jnnycn007/Neptune/32X_main1.kicad_sch

## KiCad design 32X_main1.kicad_sch (2026-05-18)

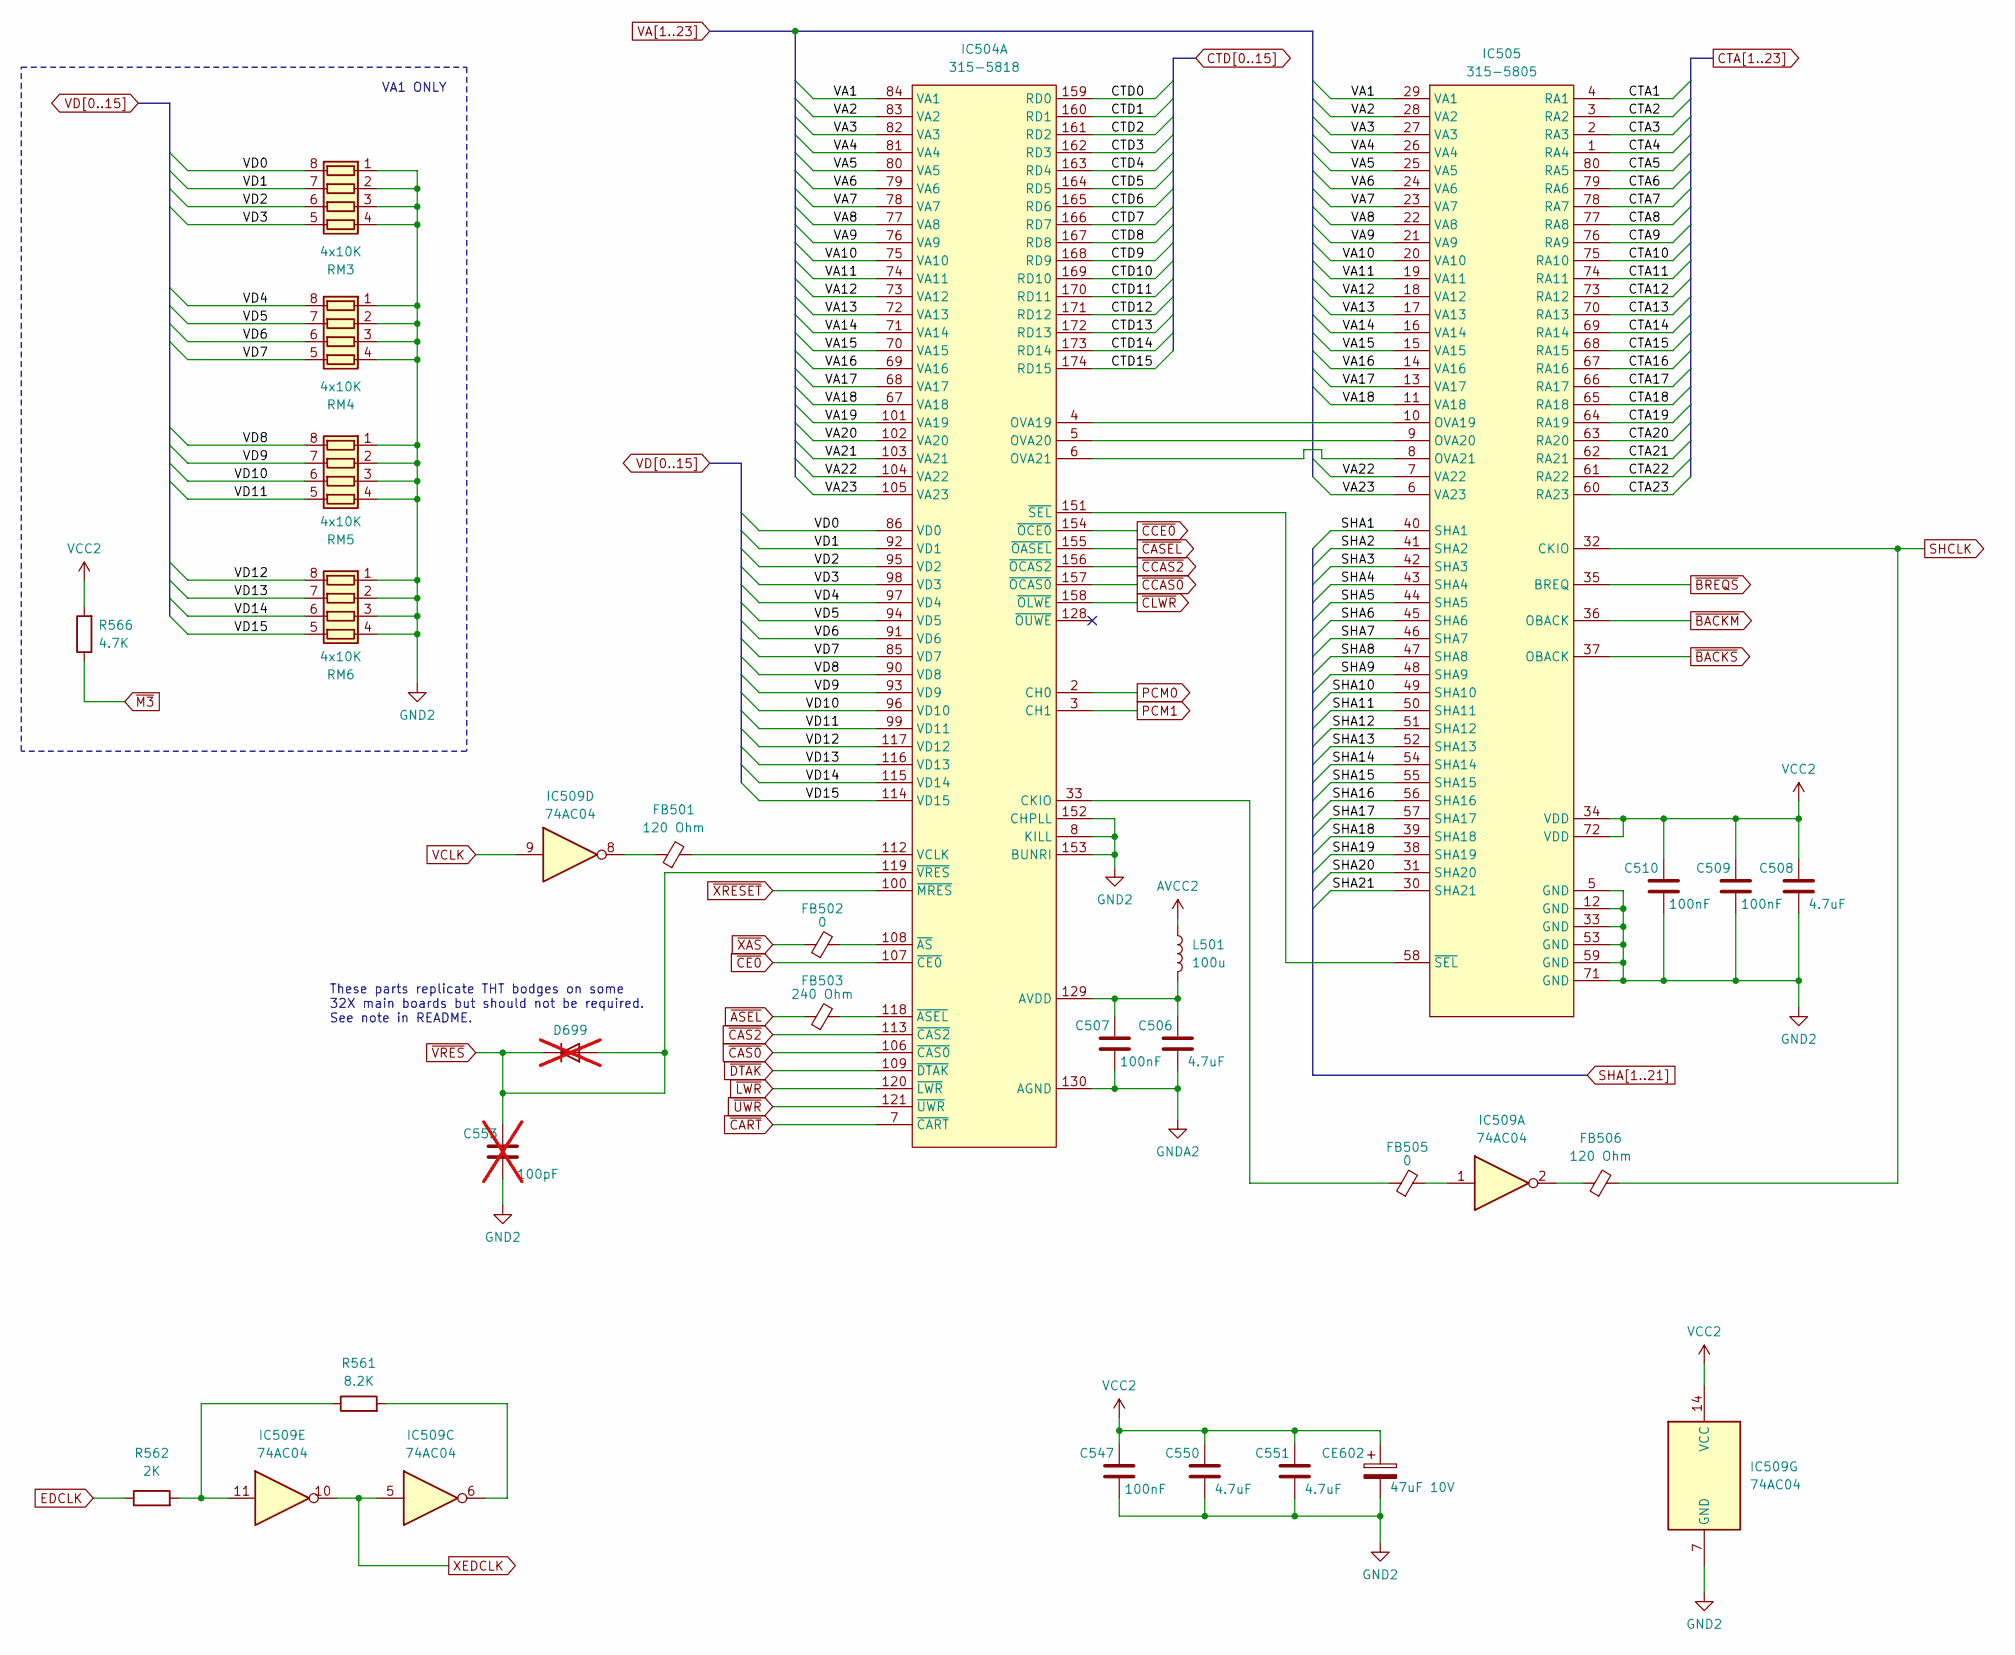
[picture p1: schematic 32X_main1.kicad_sch]

Parts:
C506, C508, C550, C551: 4.7uF; C_1206_3216Metric; MPN VJ1206V475MXJTW1BC; LCSC Part # C132170
C507, C509, C510, C547: 100nF; C_0805_2012Metric; MPN VJ0805Y104JXJMT; LCSC Part # C111492
C553: 100pF; C_0805_2012Metric; not fitted
CE602: 47uF 10V; CP_Radial_D5.0mm_P2.50mm
D699: D_1206_3216Metric; not fitted
FB501, FB506: 120 Ohm; L_0805_2012Metric; MPN CBG201209U121T; LCSC Part # C41330
FB502, FB505: 0; L_0805_2012Metric; MPN CBG201209U000T; LCSC Part # C91037
FB503: 240 Ohm; L_0805_2012Metric; MPN CBG201209U221T; LCSC Part # C124102
IC504: 315-5818; LQFP-176_24x24mm_P0.5mm
IC505: 315-5805; PQFP-80_14x20mm_P0.8mm
IC509: 74AC04; SO-14_Dual_Purpose_P1.27mm; MPN SN74AC04DR; LCSC Part # C352940
L501: 100u; L_1210_3225Metric_Pad1.42x2.65mm_HandSolder; MPN CMI322513J101KT; LCSC Part # C27775
R561: 8.2K; R_0805_2012Metric; MPN CRCW08058K20FKEA; LCSC Part # C844640
R562: 2K; R_0805_2012Metric; MPN CRCW08052K00JNEA; LCSC Part # C2077049
R566: 4.7K; R_0805_2012Metric; MPN CRCW08054K70JNEAC; LCSC Part # C2077067
RM3, RM4, RM5, RM6: 4x10K; R_Array_Convex_4x0603; MPN YC164-FR-0710KL; LCSC Part # C110924

Connections:
AVCC2: L501.1
CTA1: IC505.4 (RA1)
CTA2: IC505.3 (RA2)
CTA3: IC505.2 (RA3)
CTA4: IC505.1 (RA4)
CTA5: IC505.80 (RA5)
CTA6: IC505.79 (RA6)
CTA7: IC505.78 (RA7)
CTA8: IC505.77 (RA8)
CTA9: IC505.76 (RA9)
CTA10: IC505.75 (RA10)
CTA11: IC505.74 (RA11)
CTA12: IC505.73 (RA12)
CTA13: IC505.70 (RA13)
CTA14: IC505.69 (RA14)
CTA15: IC505.68 (RA15)
CTA16: IC505.67 (RA16)
CTA17: IC505.66 (RA17)
CTA18: IC505.65 (RA18)
CTA19: IC505.64 (RA19)
CTA20: IC505.63 (RA20)
CTA21: IC505.62 (RA21)
CTA22: IC505.61 (RA22)
CTA23: IC505.60 (RA23)
CTD0: IC504.159 (RD0)
CTD1: IC504.160 (RD1)
CTD2: IC504.161 (RD2)
CTD3: IC504.162 (RD3)
CTD4: IC504.163 (RD4)
CTD5: IC504.164 (RD5)
CTD6: IC504.165 (RD6)
CTD7: IC504.166 (RD7)
CTD8: IC504.167 (RD8)
CTD9: IC504.168 (RD9)
CTD10: IC504.169 (RD10)
CTD11: IC504.170 (RD11)
CTD12: IC504.171 (RD12)
CTD13: IC504.172 (RD13)
CTD14: IC504.173 (RD14)
CTD15: IC504.174 (RD15)
EDCLK: R562.1
GND2: C508.2, C509.2, C510.2, C547.2, C550.2, C551.2, C553.2, CE602.2, IC504.8 (KILL), IC504.152 (CHPLL), IC504.153 (BUNRI), IC505.5 (GND), IC505.12 (GND), IC505.33 (GND), IC505.53 (GND), IC505.59 (GND), IC505.71 (GND), IC509.7 (GND), RM3.1 (R1.1), RM3.2 (R2.1), RM3.3 (R3.1), RM3.4 (R4.1), RM4.1 (R1.1), RM4.2 (R2.1), RM4.3 (R3.1), RM4.4 (R4.1), RM5.1 (R1.1), RM5.2 (R2.1), RM5.3 (R3.1), RM5.4 (R4.1), RM6.1 (R1.1), RM6.2 (R2.1), RM6.3 (R3.1), RM6.4 (R4.1)
GNDA2: C506.2, C507.2, IC504.130 (AGND)
unnamed: C506.1, C507.1, IC504.129 (AVDD), L501.2
unnamed: FB501.1, IC509.8
unnamed: FB501.2, IC504.112 (VCLK)
unnamed: FB502.2, IC504.108 (~AS)
unnamed: FB503.2, IC504.118 (~ASEL)
unnamed: FB505.1, IC504.33 (CKIO)
unnamed: FB505.2, IC509.1
unnamed: FB506.1, IC509.2
unnamed: IC504.4 (OVA19), IC505.10 (OVA19)
unnamed: IC504.5 (OVA20), IC505.9 (OVA20)
unnamed: IC504.6 (OVA21), IC505.8 (OVA21)
unnamed: IC504.151 (~SEL), IC505.58 (~SEL)
unnamed: IC509.6, R561.2
unnamed: IC509.11, R561.1, R562.2
PCM0: IC504.2 (CH0)
PCM1: IC504.3 (CH1)
SHA1: IC505.40 (SHA1)
SHA2: IC505.41 (SHA2)
SHA3: IC505.42 (SHA3)
SHA4: IC505.43 (SHA4)
SHA5: IC505.44 (SHA5)
SHA6: IC505.45 (SHA6)
SHA7: IC505.46 (SHA7)
SHA8: IC505.47 (SHA8)
SHA9: IC505.48 (SHA9)
SHA10: IC505.49 (SHA10)
SHA11: IC505.50 (SHA11)
SHA12: IC505.51 (SHA12)
SHA13: IC505.52 (SHA13)
SHA14: IC505.54 (SHA14)
SHA15: IC505.55 (SHA15)
SHA16: IC505.56 (SHA16)
SHA17: IC505.57 (SHA17)
SHA18: IC505.39 (SHA18)
SHA19: IC505.38 (SHA19)
SHA20: IC505.31 (SHA20)
SHA21: IC505.30 (SHA21)
SHCLK: FB506.2, IC505.32 (CKIO)
VA1: IC504.84 (VA1), IC505.29 (VA1)
VA2: IC504.83 (VA2), IC505.28 (VA2)
VA3: IC504.82 (VA3), IC505.27 (VA3)
VA4: IC504.81 (VA4), IC505.26 (VA4)
VA5: IC504.80 (VA5), IC505.25 (VA5)
VA6: IC504.79 (VA6), IC505.24 (VA6)
VA7: IC504.78 (VA7), IC505.23 (VA7)
VA8: IC504.77 (VA8), IC505.22 (VA8)
VA9: IC504.76 (VA9), IC505.21 (VA9)
VA10: IC504.75 (VA10), IC505.20 (VA10)
VA11: IC504.74 (VA11), IC505.19 (VA11)
VA12: IC504.73 (VA12), IC505.18 (VA12)
VA13: IC504.72 (VA13), IC505.17 (VA13)
VA14: IC504.71 (VA14), IC505.16 (VA14)
VA15: IC504.70 (VA15), IC505.15 (VA15)
VA16: IC504.69 (VA16), IC505.14 (VA16)
VA17: IC504.68 (VA17), IC505.13 (VA17)
VA18: IC504.67 (VA18), IC505.11 (VA18)
VA19: IC504.101 (VA19)
VA20: IC504.102 (VA20)
VA21: IC504.103 (VA21)
VA22: IC504.104 (VA22), IC505.7 (VA22)
VA23: IC504.105 (VA23), IC505.6 (VA23)
VCC2: C508.1, C509.1, C510.1, C547.1, C550.1, C551.1, CE602.1, IC505.34 (VDD), IC505.72 (VDD), IC509.14 (VCC), R566.2
VCLK: IC509.9
VD0: IC504.86 (VD0), RM3.8 (R1.2)
VD1: IC504.92 (VD1), RM3.7 (R2.2)
VD2: IC504.95 (VD2), RM3.6 (R3.2)
VD3: IC504.98 (VD3), RM3.5 (R4.2)
VD4: IC504.97 (VD4), RM4.8 (R1.2)
VD5: IC504.94 (VD5), RM4.7 (R2.2)
VD6: IC504.91 (VD6), RM4.6 (R3.2)
VD7: IC504.85 (VD7), RM4.5 (R4.2)
VD8: IC504.90 (VD8), RM5.8 (R1.2)
VD9: IC504.93 (VD9), RM5.7 (R2.2)
VD10: IC504.96 (VD10), RM5.6 (R3.2)
VD11: IC504.99 (VD11), RM5.5 (R4.2)
VD12: IC504.117 (VD12), RM6.8 (R1.2)
VD13: IC504.116 (VD13), RM6.7 (R2.2)
VD14: IC504.115 (VD14), RM6.6 (R3.2)
VD15: IC504.114 (VD15), RM6.5 (R4.2)
XEDCLK: IC509.5, IC509.10
~ASEL: FB503.1
~BACKM: IC505.36 (OBACK)
~BACKS: IC505.37 (OBACK)
~BREQS: IC505.35 (BREQ)
~CART: IC504.7 (~CART)
~CAS0: IC504.106 (~CAS0)
~CAS2: IC504.113 (~CAS2)
~CASEL: IC504.155 (~OASEL)
~CCAS0: IC504.157 (~OCAS0)
~CCAS2: IC504.156 (~OCAS2)
~CCE0: IC504.154 (~OCE0)
~CE0: IC504.107 (~CE0)
~CLWR: IC504.158 (~OLWE)
~DTAK: IC504.109 (~DTAK)
~LWR: IC504.120 (~LWR)
~M3: R566.1
~UWR: IC504.121 (~UWR)
~VRES: C553.1, D699.1 (K), D699.2 (A), IC504.119 (~VRES)
~XAS: FB502.1
~XRESET: IC504.100 (~MRES)

Notes on the sheet:
VA1 ONLY
These parts replicate THT bodges on some 32X main boards but should not be required. See note in README.
