jnnycn007/Neptune/32X_main2.kicad_sch

## KiCad design 32X_main2.kicad_sch (2026-05-18)

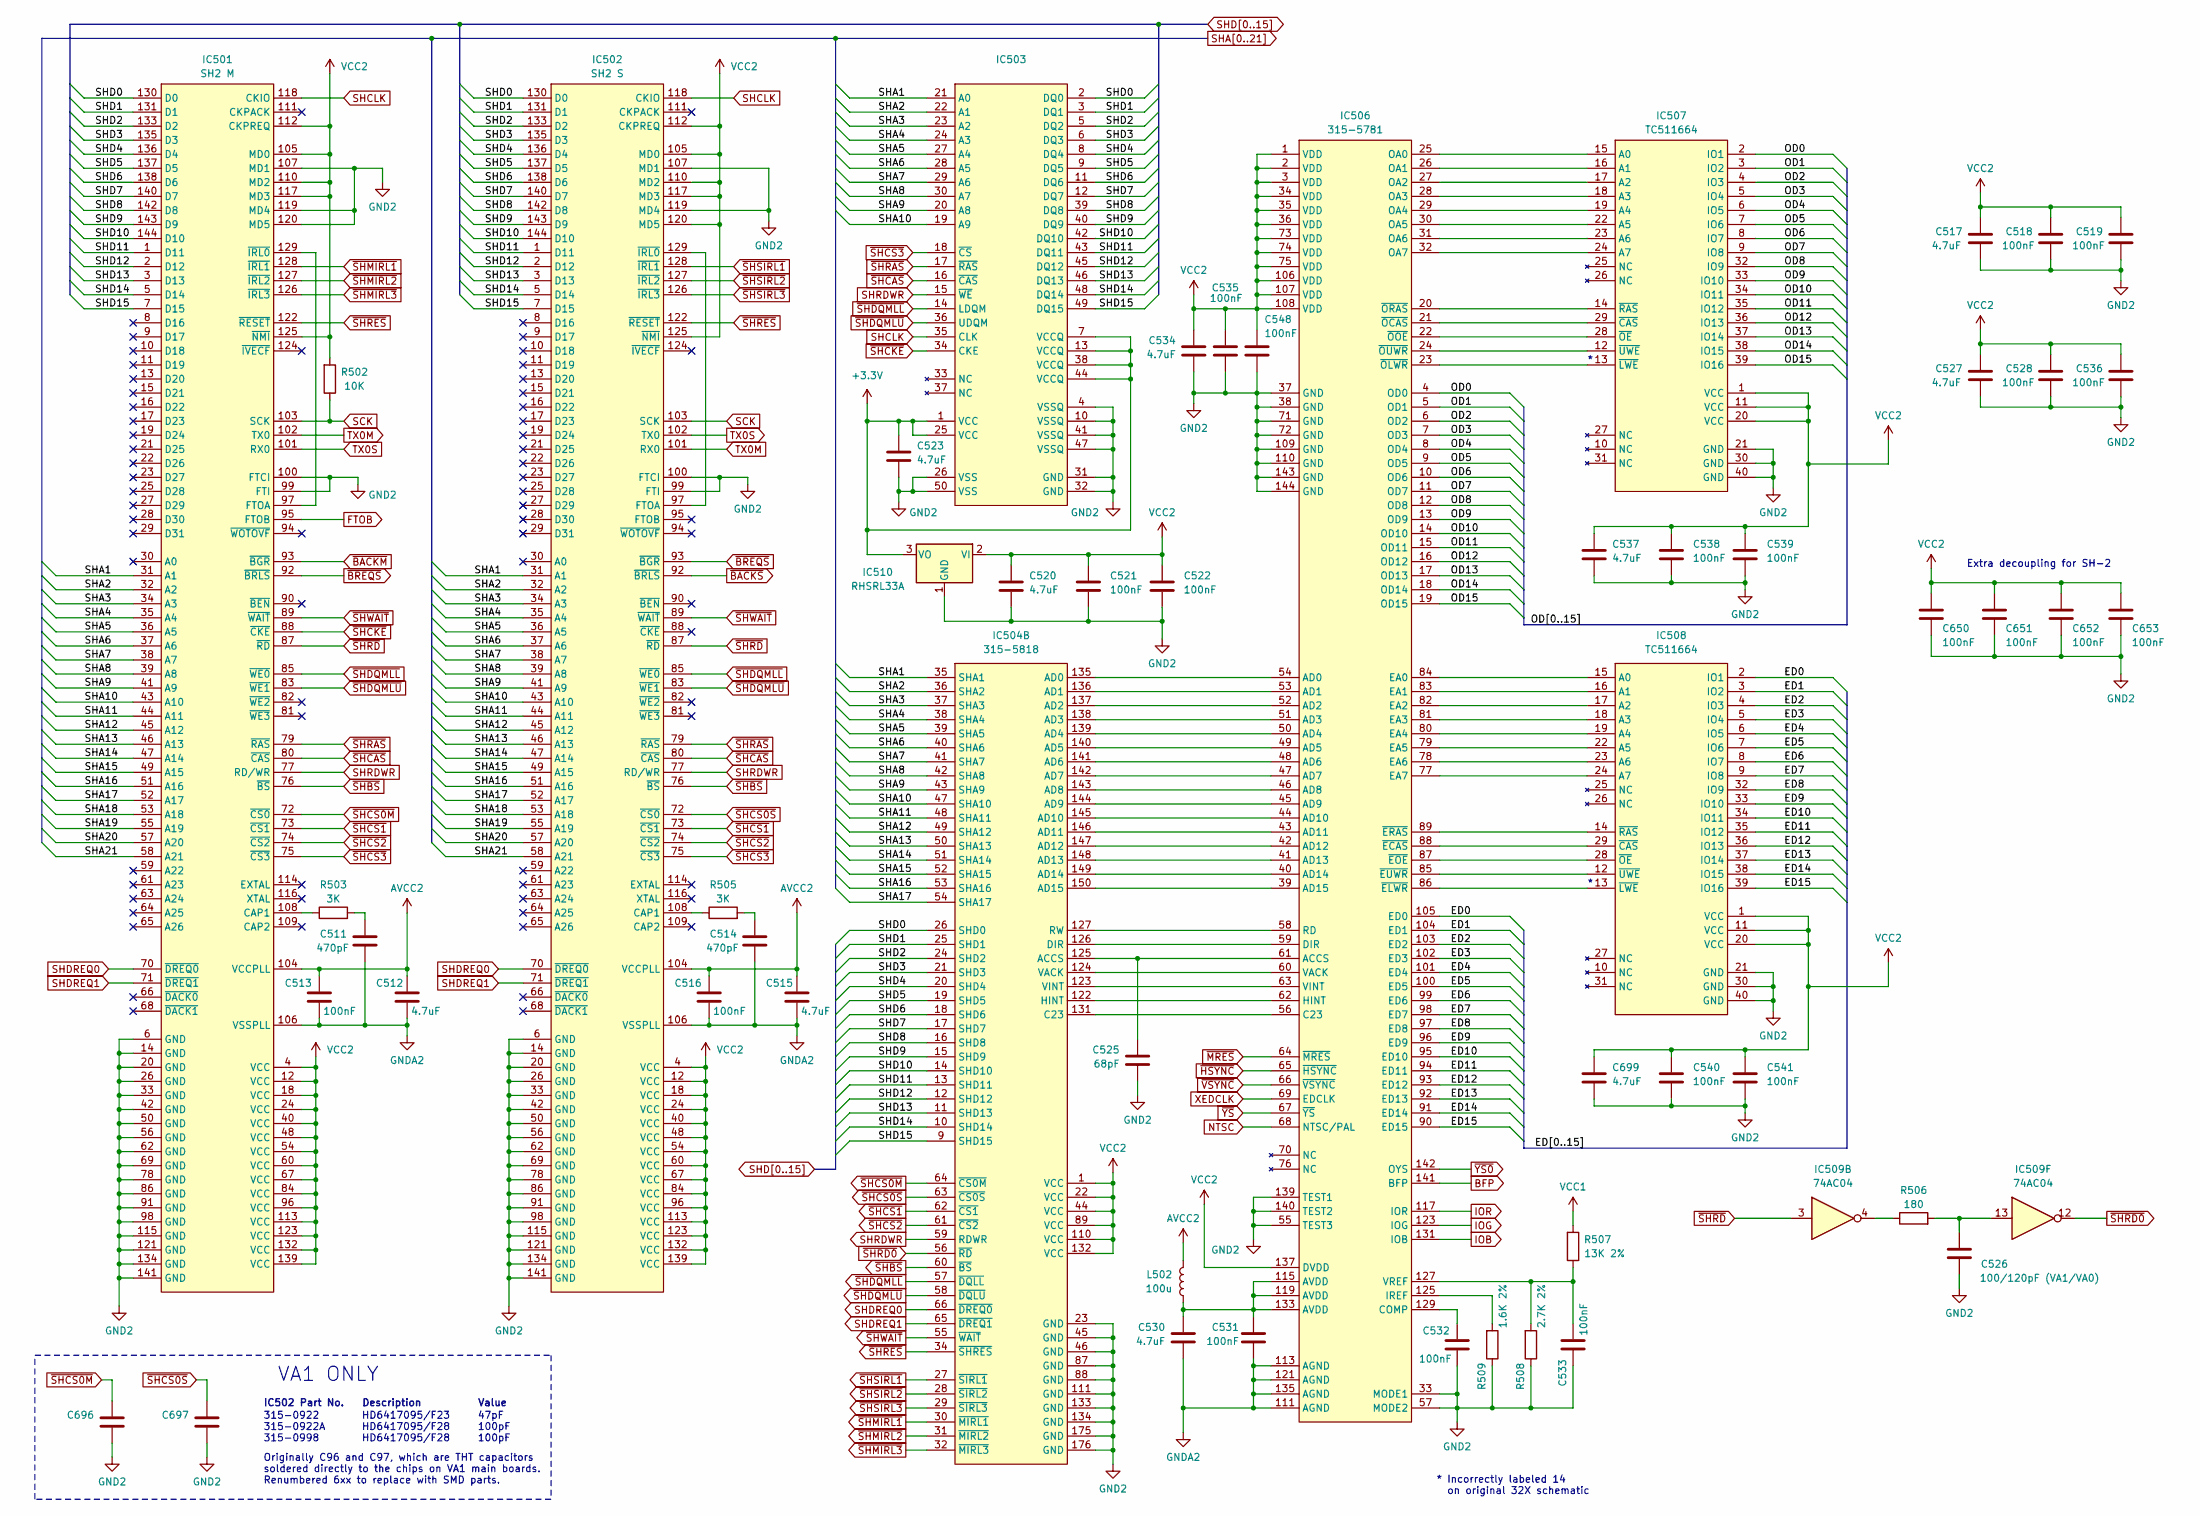
[picture p2: schematic 32X_main2.kicad_sch]

Parts:
C511, C514: 470pF; C_0805_2012Metric; MPN VJ0805A471FXJPW1BC; LCSC Part # C62771
C512, C515, C517, C520, C523, C527, C530, C534, C537, C699: 4.7uF; C_1206_3216Metric; MPN VJ1206V475MXJTW1BC; LCSC Part # C132170
C513, C516, C518, C519, C521, C522, C528, C531, C532, C533, C535, C536, C538, C539, C540, C541, C548, C650, C651, C652, C653: 100nF; C_0805_2012Metric; MPN VJ0805Y104JXJMT; LCSC Part # C111492
C525: 68pF; C_0805_2012Metric; MPN GRM21A5C2J680JWA1D; LCSC Part # C162306
C526: 100/120pF (VA1/VA0); C_0805_2012Metric; MPN VJ0805A101FXJPW1BC; LCSC Part # C62768
C696, C697: Unused/47/100pF; C_0805_2012Metric; MPN VJ0805A101FXJPW1BC; LCSC Part # C1854109
IC501: SH2 M; LQFP-144_20x20mm_P0.5mm
IC502: SH2 S; LQFP-144_20x20mm_P0.5mm
IC503: µPD4502161; SSOP-50
IC504: 315-5818; LQFP-176_24x24mm_P0.5mm
IC506: 315-5781; LQFP-144_20x20mm_P0.5mm
IC507, IC508: TC511664; SO-Mix-40
IC509: 74AC04; SO-14_Dual_Purpose_P1.27mm; MPN SN74AC04DR; LCSC Part # C352940
IC510: RHSRL33A; SOT-89-3_Handsoldering
L502: 100u; L_1210_3225Metric_Pad1.42x2.65mm_HandSolder; MPN CMI322513J101KT; LCSC Part # C27775
R502: 10K; R_0805_2012Metric; MPN CRCW080510K0FKEA; LCSC Part # C844937
R503, R505: 3K; R_0805_2012Metric; MPN CRCW08053K00FKEA; LCSC Part # C114222
R506: 180; R_0805_2012Metric; MPN CRCW0805180RJNEA; LCSC Part # C137585
R507: 13K 2%; R_0805_2012Metric; MPN CRCW080513K0FKEA; LCSC Part # C844395
R508: 2.7K 2%; R_0805_2012Metric; MPN CRCW08052K70FKEA; LCSC Part # C844836
R509: 1.6K 2%; R_0805_2012Metric; MPN CRCW08051K60FKEA; LCSC Part # C185279

Connections:
+3.3V: C523.1, IC503.1 (VCC), IC503.7 (VCCQ), IC503.13 (VCCQ), IC503.25 (VCC), IC503.38 (VCCQ), IC503.44 (VCCQ), IC510.3 (VO)
AVCC2: C512.1, C513.1, C515.1, C516.1, IC501.104 (VCCPLL), IC502.104 (VCCPLL), L502.1
BFP: IC506.141 (BFP)
ED0: IC506.105 (ED0), IC508.2 (IO1)
ED1: IC506.104 (ED1), IC508.3 (IO2)
ED2: IC506.103 (ED2), IC508.4 (IO3)
ED3: IC506.102 (ED3), IC508.5 (IO4)
ED4: IC506.101 (ED4), IC508.6 (IO5)
ED5: IC506.100 (ED5), IC508.7 (IO6)
ED6: IC506.99 (ED6), IC508.8 (IO7)
ED7: IC506.98 (ED7), IC508.9 (IO8)
ED8: IC506.97 (ED8), IC508.32 (IO9)
ED9: IC506.96 (ED9), IC508.33 (IO10)
ED10: IC506.95 (ED10), IC508.34 (IO11)
ED11: IC506.94 (ED11), IC508.35 (IO12)
ED12: IC506.93 (ED12), IC508.36 (IO13)
ED13: IC506.92 (ED13), IC508.37 (IO14)
ED14: IC506.91 (ED14), IC508.38 (IO15)
ED15: IC506.90 (ED15), IC508.39 (IO16)
FTOB: IC501.95 (FTOB)
GND2: C517.2, C518.2, C519.2, C520.2, C521.2, C522.2, C523.2, C525.2, C526.2, C527.2, C528.2, C532.2, C533.2, C534.2, C535.2, C536.2, C537.2, C538.2, C539.2, C540.2, C541.2, C548.2, C650.2, C651.2, C652.2, C653.2, C696.2, C697.2, C699.2, IC501.6 (GND), IC501.14 (GND), IC501.20 (GND), IC501.26 (GND), IC501.33 (GND), IC501.42 (GND), IC501.50 (GND), IC501.56 (GND), IC501.62 (GND), IC501.69 (GND), IC501.78 (GND), IC501.86 (GND), IC501.91 (GND), IC501.98 (GND), IC501.99 (FTI), IC501.100 (FTCI), IC501.107 (MD1), IC501.115 (GND), IC501.119 (MD4), IC501.120 (MD5), IC501.121 (GND), IC501.134 (GND), IC501.141 (GND), IC502.6 (GND), IC502.14 (GND), IC502.20 (GND), IC502.26 (GND), IC502.33 (GND), IC502.42 (GND), IC502.50 (GND), IC502.56 (GND), IC502.62 (GND), IC502.69 (GND), IC502.78 (GND), IC502.86 (GND), IC502.91 (GND), IC502.98 (GND), IC502.99 (FTI), IC502.100 (FTCI), IC502.107 (MD1), IC502.115 (GND), IC502.119 (MD4), IC502.121 (GND), IC502.134 (GND), IC502.141 (GND), IC503.4 (VSSQ), IC503.10 (VSSQ), IC503.26 (VSS), IC503.31 (GND), IC503.32 (GND), IC503.41 (VSSQ), IC503.47 (VSSQ), IC503.50 (VSS), IC504.23 (GND), IC504.45 (GND), IC504.46 (GND), IC504.87 (GND), IC504.88 (GND), IC504.111 (GND), IC504.133 (GND), IC504.134 (GND), IC504.175 (GND), IC504.176 (GND), IC506.33 (MODE1), IC506.37 (GND), IC506.38 (GND), IC506.55 (TEST3), IC506.57 (MODE2), IC506.71 (GND), IC506.72 (GND), IC506.109 (GND), IC506.110 (GND), IC506.139 (TEST1), IC506.140 (TEST2), IC506.143 (GND), IC506.144 (GND), IC507.21 (GND), IC507.30 (GND), IC507.40 (GND), IC508.21 (GND), IC508.30 (GND), IC508.40 (GND), IC510.1 (GND), R508.1, R509.1
GNDA2: C511.2, C512.2, C513.2, C514.2, C515.2, C516.2, C530.2, C531.2, IC501.106 (VSSPLL), IC502.106 (VSSPLL), IC506.111 (AGND), IC506.113 (AGND), IC506.121 (AGND), IC506.135 (AGND)
IOB: IC506.131 (IOB)
IOG: IC506.123 (IOG)
IOR: IC506.117 (IOR)
NTSC: IC506.68 (NTSC/PAL)
unnamed: C511.1, R503.2
unnamed: C514.1, R505.2
unnamed: C525.1, IC504.125 (ACCS), IC506.61 (ACCS)
unnamed: C526.1, IC509.13, R506.2
unnamed: C530.1, C531.1, IC506.115 (AVDD), IC506.119 (AVDD), IC506.133 (AVDD), L502.2
unnamed: C532.1, IC506.129 (COMP)
unnamed: C533.1, IC506.127 (VREF), R507.1, R508.2
unnamed: IC501.108 (CAP1), R503.1
unnamed: IC501.97 (FTOA), IC501.129 (~IRL0)
unnamed: IC502.108 (CAP1), R505.1
unnamed: IC502.97 (FTOA), IC502.129 (~IRL0)
unnamed: IC504.122 (HINT), IC506.62 (HINT)
unnamed: IC504.123 (VINT), IC506.63 (VINT)
unnamed: IC504.124 (VACK), IC506.60 (VACK)
unnamed: IC504.126 (DIR), IC506.59 (DIR)
unnamed: IC504.127 (RW), IC506.58 (RD)
unnamed: IC504.131 (C23), IC506.56 (C23)
unnamed: IC504.135 (AD0), IC506.54 (AD0)
unnamed: IC504.136 (AD1), IC506.53 (AD1)
unnamed: IC504.137 (AD2), IC506.52 (AD2)
unnamed: IC504.138 (AD3), IC506.51 (AD3)
unnamed: IC504.139 (AD4), IC506.50 (AD4)
unnamed: IC504.140 (AD5), IC506.49 (AD5)
unnamed: IC504.141 (AD6), IC506.48 (AD6)
unnamed: IC504.142 (AD7), IC506.47 (AD7)
unnamed: IC504.143 (AD8), IC506.46 (AD8)
unnamed: IC504.144 (AD9), IC506.45 (AD9)
unnamed: IC504.145 (AD10), IC506.44 (AD10)
unnamed: IC504.146 (AD11), IC506.43 (AD11)
unnamed: IC504.147 (AD12), IC506.42 (AD12)
unnamed: IC504.148 (AD13), IC506.41 (AD13)
unnamed: IC504.149 (AD14), IC506.40 (AD14)
unnamed: IC504.150 (AD15), IC506.39 (AD15)
unnamed: IC506.20 (~ORAS), IC507.14 (~RAS)
unnamed: IC506.21 (~OCAS), IC507.29 (~CAS)
unnamed: IC506.22 (~OOE), IC507.28 (~OE)
unnamed: IC506.23 (~OLWR), IC507.13 (~LWE)
unnamed: IC506.24 (~OUWR), IC507.12 (~UWE)
unnamed: IC506.25 (OA0), IC507.15 (A0)
unnamed: IC506.26 (OA1), IC507.16 (A1)
unnamed: IC506.27 (OA2), IC507.17 (A2)
unnamed: IC506.28 (OA3), IC507.18 (A3)
unnamed: IC506.29 (OA4), IC507.19 (A4)
unnamed: IC506.30 (OA5), IC507.22 (A5)
unnamed: IC506.31 (OA6), IC507.23 (A6)
unnamed: IC506.32 (OA7), IC507.24 (A7)
unnamed: IC506.77 (EA7), IC508.24 (A7)
unnamed: IC506.78 (EA6), IC508.23 (A6)
unnamed: IC506.79 (EA5), IC508.22 (A5)
unnamed: IC506.80 (EA4), IC508.19 (A4)
unnamed: IC506.81 (EA3), IC508.18 (A3)
unnamed: IC506.82 (EA2), IC508.17 (A2)
unnamed: IC506.83 (EA1), IC508.16 (A1)
unnamed: IC506.84 (EA0), IC508.15 (A0)
unnamed: IC506.85 (~EUWR), IC508.12 (~UWE)
unnamed: IC506.86 (~ELWR), IC508.13 (~LWE)
unnamed: IC506.87 (~EOE), IC508.28 (~OE)
unnamed: IC506.88 (~ECAS), IC508.29 (~CAS)
unnamed: IC506.89 (~ERAS), IC508.14 (~RAS)
unnamed: IC506.125 (IREF), R509.2
unnamed: IC509.4, R506.1
OD0: IC506.4 (OD0), IC507.2 (IO1)
OD1: IC506.5 (OD1), IC507.3 (IO2)
OD2: IC506.6 (OD2), IC507.4 (IO3)
OD3: IC506.7 (OD3), IC507.5 (IO4)
OD4: IC506.8 (OD4), IC507.6 (IO5)
OD5: IC506.9 (OD5), IC507.7 (IO6)
OD6: IC506.10 (OD6), IC507.8 (IO7)
OD7: IC506.11 (OD7), IC507.9 (IO8)
OD8: IC506.12 (OD8), IC507.32 (IO9)
OD9: IC506.13 (OD9), IC507.33 (IO10)
OD10: IC506.14 (OD10), IC507.34 (IO11)
OD11: IC506.15 (OD11), IC507.35 (IO12)
OD12: IC506.16 (OD12), IC507.36 (IO13)
OD13: IC506.17 (OD13), IC507.37 (IO14)
OD14: IC506.18 (OD14), IC507.38 (IO15)
OD15: IC506.19 (OD15), IC507.39 (IO16)
SCK: IC501.103 (SCK), IC502.103 (SCK), R502.1
SHA1: IC501.31 (A1), IC502.31 (A1), IC503.21 (A0), IC504.35 (SHA1)
SHA2: IC501.32 (A2), IC502.32 (A2), IC503.22 (A1), IC504.36 (SHA2)
SHA3: IC501.34 (A3), IC502.34 (A3), IC503.23 (A2), IC504.37 (SHA3)
SHA4: IC501.35 (A4), IC502.35 (A4), IC503.24 (A3), IC504.38 (SHA4)
SHA5: IC501.36 (A5), IC502.36 (A5), IC503.27 (A4), IC504.39 (SHA5)
SHA6: IC501.37 (A6), IC502.37 (A6), IC503.28 (A5), IC504.40 (SHA6)
SHA7: IC501.38 (A7), IC502.38 (A7), IC503.29 (A6), IC504.41 (SHA7)
SHA8: IC501.39 (A8), IC502.39 (A8), IC503.30 (A7), IC504.42 (SHA8)
SHA9: IC501.41 (A9), IC502.41 (A9), IC503.20 (A8), IC504.43 (SHA9)
SHA10: IC501.43 (A10), IC502.43 (A10), IC503.19 (A9), IC504.47 (SHA10)
SHA11: IC501.44 (A11), IC502.44 (A11), IC504.48 (SHA11)
SHA12: IC501.45 (A12), IC502.45 (A12), IC504.49 (SHA12)
SHA13: IC501.46 (A13), IC502.46 (A13), IC504.50 (SHA13)
SHA14: IC501.47 (A14), IC502.47 (A14), IC504.51 (SHA14)
SHA15: IC501.49 (A15), IC502.49 (A15), IC504.52 (SHA15)
SHA16: IC501.51 (A16), IC502.51 (A16), IC504.53 (SHA16)
SHA17: IC501.52 (A17), IC502.52 (A17), IC504.54 (SHA17)
SHA18: IC501.53 (A18), IC502.53 (A18)
SHA19: IC501.55 (A19), IC502.55 (A19)
SHA20: IC501.57 (A20), IC502.57 (A20)
SHA21: IC501.58 (A21), IC502.58 (A21)
SHCLK: IC501.118 (CKIO), IC502.118 (CKIO), IC503.35 (CLK)
SHD0: IC501.130 (D0), IC502.130 (D0), IC503.2 (DQ0), IC504.26 (SHD0)
SHD1: IC501.131 (D1), IC502.131 (D1), IC503.3 (DQ1), IC504.25 (SHD1)
SHD2: IC501.133 (D2), IC502.133 (D2), IC503.5 (DQ2), IC504.24 (SHD2)
SHD3: IC501.135 (D3), IC502.135 (D3), IC503.6 (DQ3), IC504.21 (SHD3)
SHD4: IC501.136 (D4), IC502.136 (D4), IC503.8 (DQ4), IC504.20 (SHD4)
SHD5: IC501.137 (D5), IC502.137 (D5), IC503.9 (DQ5), IC504.19 (SHD5)
SHD6: IC501.138 (D6), IC502.138 (D6), IC503.11 (DQ6), IC504.18 (SHD6)
SHD7: IC501.140 (D7), IC502.140 (D7), IC503.12 (DQ7), IC504.17 (SHD7)
SHD8: IC501.142 (D8), IC502.142 (D8), IC503.39 (DQ8), IC504.16 (SHD8)
SHD9: IC501.143 (D9), IC502.143 (D9), IC503.40 (DQ9), IC504.15 (SHD9)
SHD10: IC501.144 (D10), IC502.144 (D10), IC503.42 (DQ10), IC504.14 (SHD10)
SHD11: IC501.1 (D11), IC502.1 (D11), IC503.43 (DQ11), IC504.13 (SHD11)
SHD12: IC501.2 (D12), IC502.2 (D12), IC503.45 (DQ12), IC504.12 (SHD12)
SHD13: IC501.3 (D13), IC502.3 (D13), IC503.46 (DQ13), IC504.11 (SHD13)
SHD14: IC501.5 (D14), IC502.5 (D14), IC503.48 (DQ14), IC504.10 (SHD14)
SHD15: IC501.7 (D15), IC502.7 (D15), IC503.49 (DQ15), IC504.9 (SHD15)
SHDREQ0: IC501.70 (~DREQ0), IC502.70 (~DREQ0), IC504.66 (~DREQ0)
SHDREQ1: IC501.71 (~DREQ1), IC502.71 (~DREQ1), IC504.65 (~DREQ1)
SHRDWR: IC501.77 (RD/WR), IC502.77 (RD/WR), IC503.15 (~WE), IC504.59 (RDWR)
TX0M: IC501.102 (TX0), IC502.101 (RX0)
TX0S: IC501.101 (RX0), IC502.102 (TX0)
VCC1: R507.2
VCC2: C517.1, C518.1, C519.1, C520.1, C521.1, C522.1, C527.1, C528.1, C534.1, C535.1, C536.1, C537.1, C538.1, C539.1, C540.1, C541.1, C548.1, C650.1, C651.1, C652.1, C653.1, C699.1, IC501.4 (VCC), IC501.12 (VCC), IC501.18 (VCC), IC501.24 (VCC), IC501.40 (VCC), IC501.48 (VCC), IC501.54 (VCC), IC501.60 (VCC), IC501.67 (VCC), IC501.84 (VCC), IC501.96 (VCC), IC501.105 (MD0), IC501.110 (MD2), IC501.112 (CKPREQ), IC501.113 (VCC), IC501.117 (MD3), IC501.123 (VCC), IC501.125 (~NMI), IC501.132 (VCC), IC501.139 (VCC), IC502.4 (VCC), IC502.12 (VCC), IC502.18 (VCC), IC502.24 (VCC), IC502.40 (VCC), IC502.48 (VCC), IC502.54 (VCC), IC502.60 (VCC), IC502.67 (VCC), IC502.84 (VCC), IC502.96 (VCC), IC502.105 (MD0), IC502.110 (MD2), IC502.112 (CKPREQ), IC502.113 (VCC), IC502.117 (MD3), IC502.120 (MD5), IC502.123 (VCC), IC502.125 (~NMI), IC502.132 (VCC), IC502.139 (VCC), IC504.1 (VCC), IC504.22 (VCC), IC504.44 (VCC), IC504.89 (VCC), IC504.110 (VCC), IC504.132 (VCC), IC506.1 (VDD), IC506.2 (VDD), IC506.3 (VDD), IC506.34 (VDD), IC506.35 (VDD), IC506.36 (VDD), IC506.73 (VDD), IC506.74 (VDD), IC506.75 (VDD), IC506.106 (VDD), IC506.107 (VDD), IC506.108 (VDD), IC506.137 (DVDD), IC507.1 (VCC), IC507.11 (VCC), IC507.20 (VCC), IC508.1 (VCC), IC508.11 (VCC), IC508.20 (VCC), IC510.2 (VI), R502.2
XEDCLK: IC506.69 (EDCLK)
~BACKM: IC501.93 (~BGR)
~BACKS: IC502.92 (~BRLS)
~BREQS: IC501.92 (~BRLS), IC502.93 (~BGR)
~HSYNC: IC506.65 (~HSYNC)
~MRES: IC506.64 (~MRES)
~SHBS: IC501.76 (~BS), IC502.76 (~BS), IC504.60 (~BS)
~SHCAS: IC501.80 (~CAS), IC502.80 (~CAS), IC503.16 (~CAS)
~SHCKE: IC501.88 (~CKE), IC503.34 (CKE)
~SHCS0M: C696.1, IC501.72 (~CS0), IC504.64 (~CS0M)
~SHCS0S: C697.1, IC502.72 (~CS0), IC504.63 (~CS0S)
~SHCS1: IC501.73 (~CS1), IC502.73 (~CS1), IC504.62 (~CS1)
~SHCS2: IC501.74 (~CS2), IC502.74 (~CS2), IC504.61 (~CS2)
~SHCS3: IC501.75 (~CS3), IC502.75 (~CS3), IC503.18 (~CS)
~SHDQMLL: IC501.85 (~WE0), IC502.85 (~WE0), IC503.14 (LDQM), IC504.57 (~DQLL)
~SHDQMLU: IC501.83 (~WE1), IC502.83 (~WE1), IC503.36 (UDQM), IC504.58 (~DQLU)
~SHMIRL1: IC501.128 (~IRL1), IC504.30 (~MIRL1)
~SHMIRL2: IC501.127 (~IRL2), IC504.31 (~MIRL2)
~SHMIRL3: IC501.126 (~IRL3), IC504.32 (~MIRL3)
~SHRAS: IC501.79 (~RAS), IC502.79 (~RAS), IC503.17 (~RAS)
~SHRD0: IC504.56 (~RD), IC509.12
~SHRD: IC501.87 (~RD), IC502.87 (~RD), IC509.3
~SHRES: IC501.122 (~RESET), IC502.122 (~RESET), IC504.34 (~SHRES)
~SHSIRL1: IC502.128 (~IRL1), IC504.27 (~SIRL1)
~SHSIRL2: IC502.127 (~IRL2), IC504.28 (~SIRL2)
~SHSIRL3: IC502.126 (~IRL3), IC504.29 (~SIRL3)
~SHWAIT: IC501.89 (~WAIT), IC502.89 (~WAIT), IC504.55 (~WAIT)
~VSYNC: IC506.66 (~VSYNC)
~YS0: IC506.142 (OYS)
~YS: IC506.67 (~YS)

Notes on the sheet:
315-0922 315-0922A 315-0998
* Incorrectly labeled 14 on original 32X schematic
VA1 ONLY
IC502 Part No.
Value
Description
47pF 100pF 100pF
Extra decoupling for SH-2
Originally C96 and C97, which are THT capacitors soldered directly to the chips on VA1 main boards. Renumbered 6xx to replace with SMD parts.
HD6417095/F23 HD6417095/F28 HD6417095/F28
