jnnycn007/Neptune/32X_sub.kicad_sch

## KiCad design 32X_sub.kicad_sch (2026-05-18)

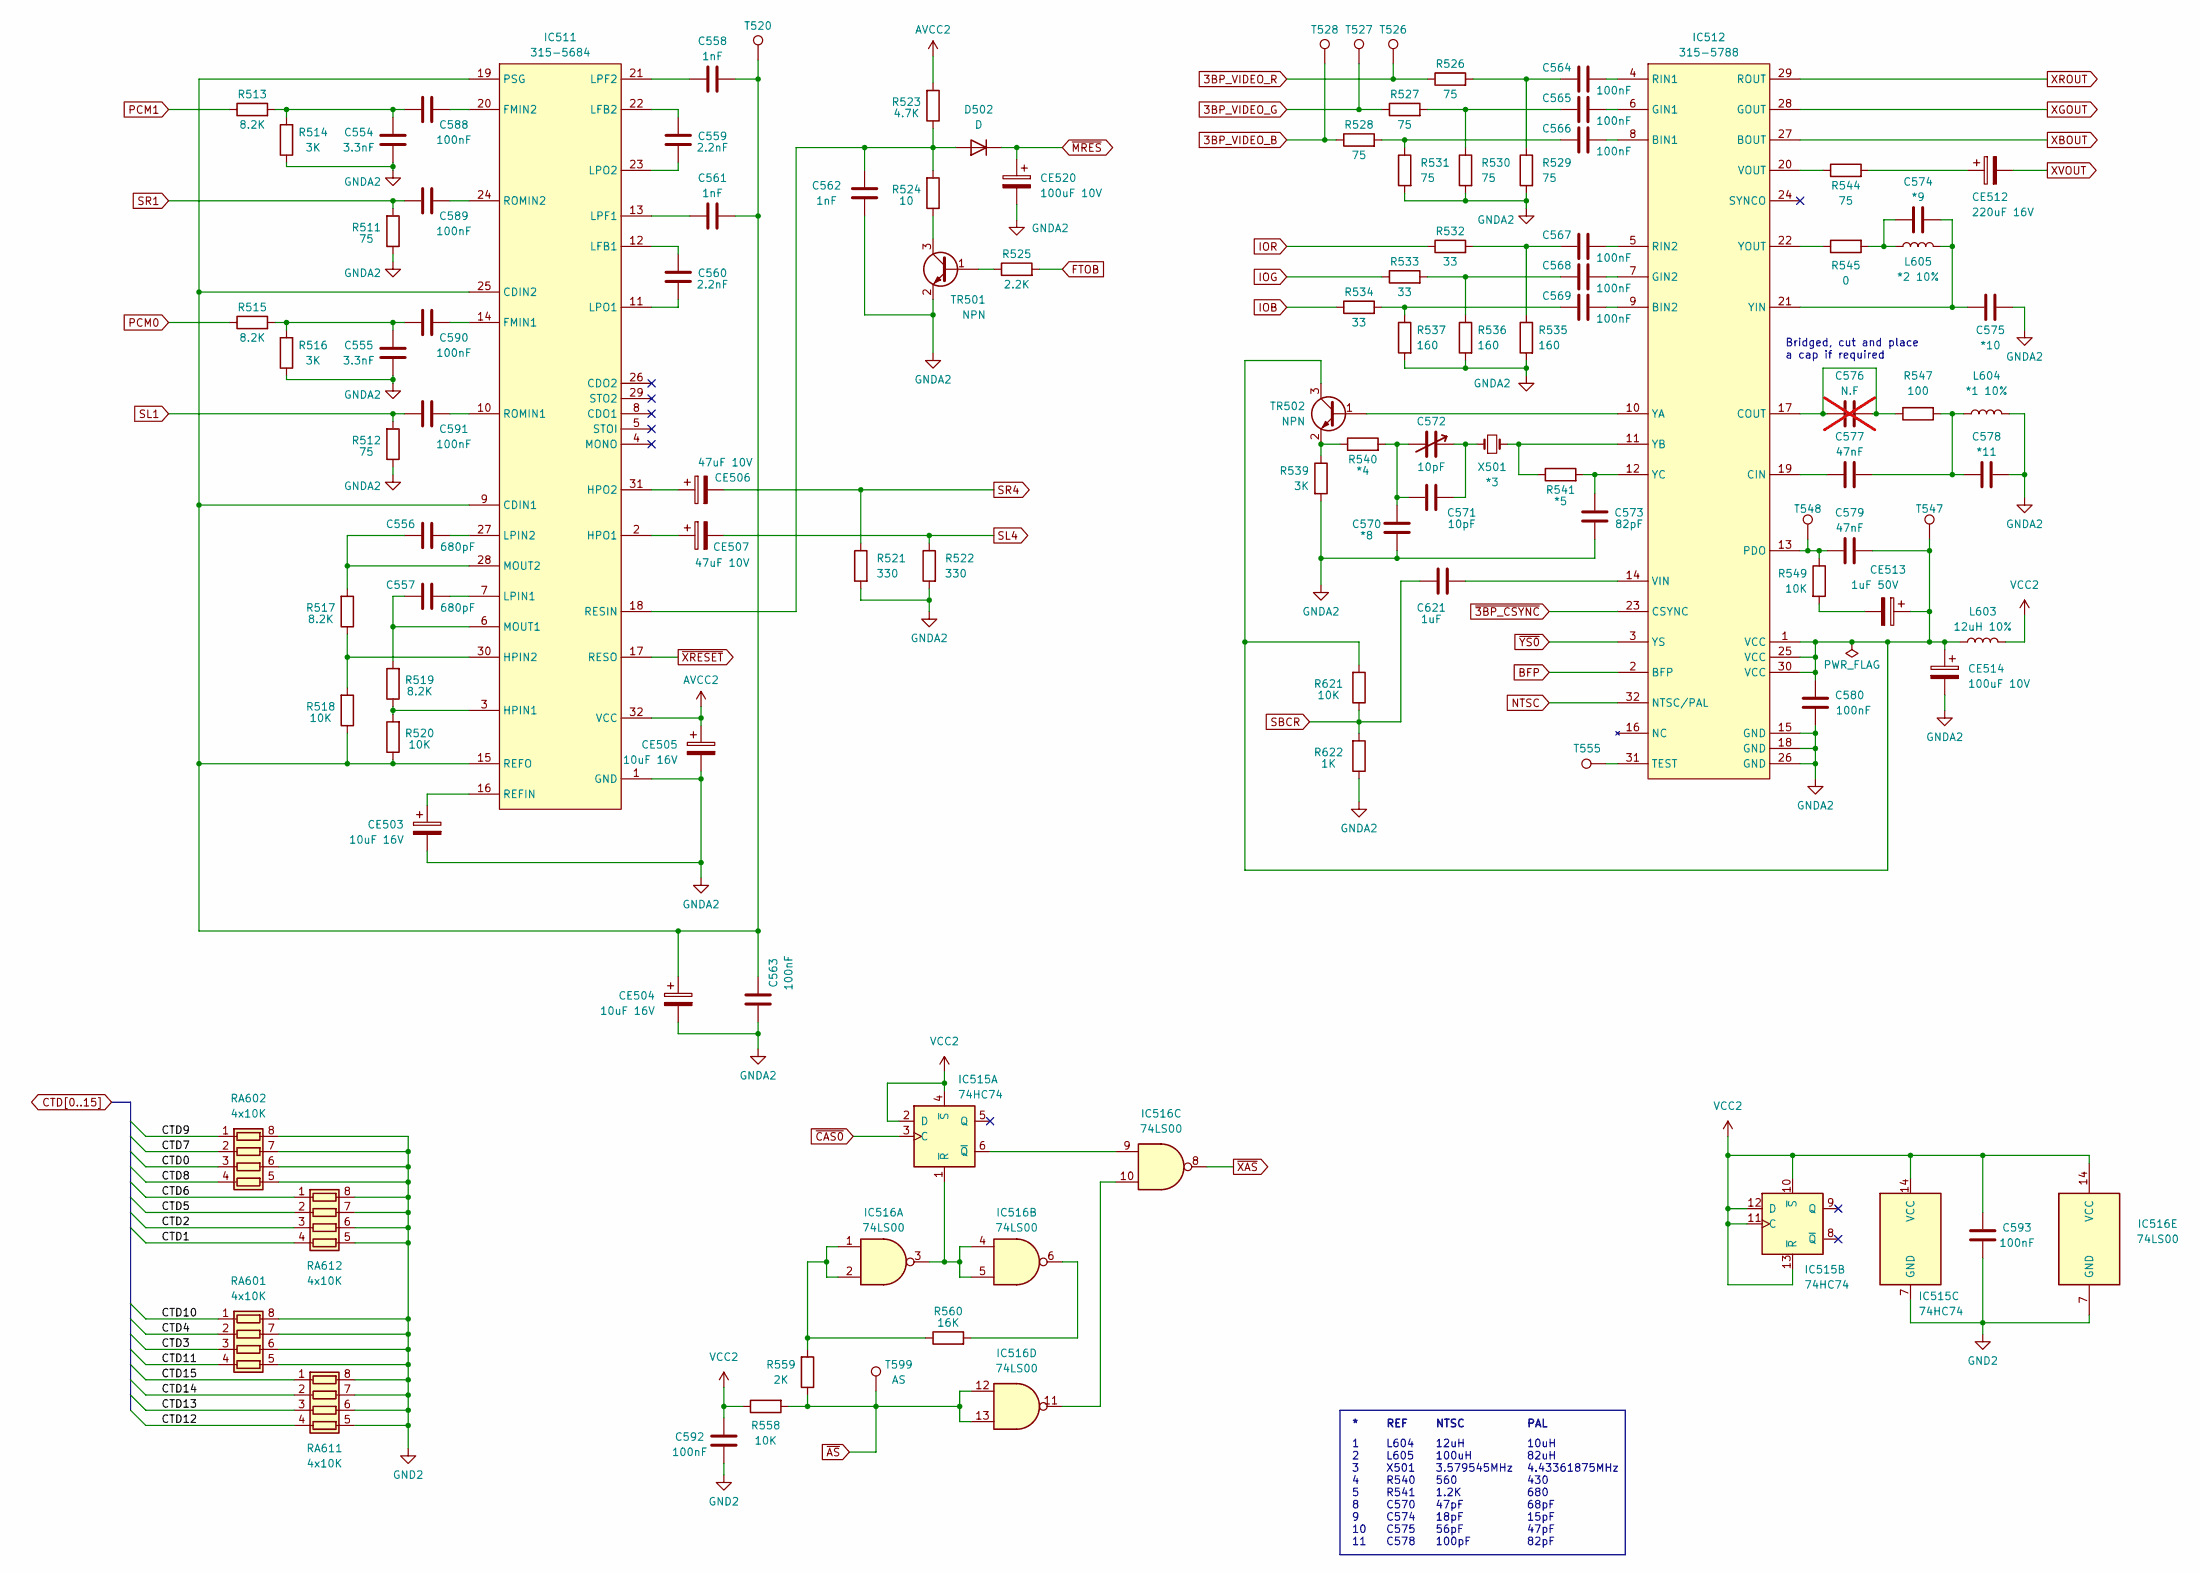
[picture p3: schematic 32X_sub.kicad_sch]

Parts:
C554, C555: 3.3nF; C_0805_2012Metric; MPN VJ0805A332FXJTW1BC; LCSC Part # C107149
C556, C557: 680pF; C_0805_2012Metric; MPN VJ0805A681FXJCW1BC; LCSC Part # C107121
C558, C561, C562: 1nF; C_0805_2012Metric; MPN VJ0805A102FXJCW1BC; LCSC Part # C62774
C559, C560: 2.2nF; C_0805_2012Metric; MPN VJ0805A222FXJCW1BC; LCSC Part # C107103
C563, C564, C565, C566, C567, C568, C569, C580, C588, C589, C590, C591, C592, C593: 100nF; C_0805_2012Metric; MPN VJ0805Y104JXJMT; LCSC Part # C111492
C570: *8; C_0805_2012Metric; MPN GRM21A5C2J680JWA1D; LCSC Part # C162306
C571: 10pF; C_0805_2012Metric; MPN VJ0805A100FXJCW1BC; LCSC Part # C520053
C572: 10pF; C_Rect_L7.0mm_W6.5mm_P5.00mm
C573: 82pF; C_0805_2012Metric; MPN VJ0805A820FXJCW1BC; LCSC Part # C327193
C574: *9; C_0805_2012Metric; MPN CC0805JRNPOCBN150; LCSC Part # C527077
C575: *10; C_0805_2012Metric; MPN GRM21A5C2E470JW01D; LCSC Part # C437549
C576: N.F; C_0805_2012Metric; not fitted
C577, C579: 47nF; C_0805_2012Metric; MPN VJ0805Y473JXJCW1BC; LCSC Part # C107154
C578: *11; C_0805_2012Metric; MPN GRM21A5C2E820JW01D; LCSC Part # C710971
C621: 1uF; C_0805_2012Metric; MPN VJ0805Y105KXJTW1BC; LCSC Part # C541528
CE503, CE504, CE505: 10uF 16V; CP_Radial_D5.0mm_P2.50mm
CE506, CE507: 47uF 10V; CP_Radial_D5.0mm_P2.50mm; DigiKey 493-13447-1-ND
CE512: 220uF 16V; CP_Radial_D5.0mm_P2.50mm
CE513: 1uF 50V; CP_Radial_D5.0mm_P2.50mm
CE514, CE520: 100uF 10V; CP_Radial_D5.0mm_P2.50mm
D502: D; D_T-1_P5.08mm_Horizontal
IC511: 315-5684; SO-32-0.8mm
IC512: 315-5788; SO-32-0.8mm
IC515: 74HC74; SO-14_Dual_Purpose_P1.27mm; MPN SN74HC74ANS; LCSC Part # C6762
IC516: 74LS00; SO-14_Dual_Purpose_P1.27mm; MPN SN74LS00NSR; LCSC Part # C140269
L603: 12uH 10%; L_1210_3225Metric_Pad1.42x2.65mm_HandSolder; MPN CMI322513X120KT; LCSC Part # C394998
L604: *1 10%; L_1210_3225Metric_Pad1.42x2.65mm_HandSolder; MPN FHW1210IF100JST; LCSC Part # C75643
L605: *2 10%; L_1210_3225Metric_Pad1.42x2.65mm_HandSolder; MPN FHW1210IF820JST; LCSC Part # C394099
R511, R512, R544: 75; R_0805_2012Metric; MPN CRCW080575R0FKEAHP; DigiKey P75.0CCT-ND
R513, R515, R517, R519: 8.2K; R_0805_2012Metric; MPN CRCW08058K20FKEA; LCSC Part # C844640
R514, R516, R539: 3K; R_0805_2012Metric; MPN CRCW08053K00FKEA; LCSC Part # C114222
R518, R520, R549, R558, R621: 10K; R_0805_2012Metric; MPN CRCW080510K0FKEA; LCSC Part # C844937
R521, R522: 330; R_0805_2012Metric; MPN CRCW0805330RFKEA; LCSC Part # C844839
R523: 4.7K; R_0805_2012Metric; MPN CRCW08054K70JNEAC; LCSC Part # C2077067
R524: 10; R_0805_2012Metric; MPN CRCW080510R0FKEB; LCSC Part # C96347
R525: 2.2K; R_0805_2012Metric; MPN CRCW08052K20JNEA; DigiKey P2.20KCCT-ND
R526, R527, R528: 75; R_0805_2012Metric; MPN CRCW080575R0FKEAHP; DigiKey P5.62KCCT-ND
R529, R530, R531: 75; R_0805_2012Metric; MPN CRCW080575R0FKEAHP; DigiKey P1.00KCCT-ND
R532, R533, R534: 33; R_0805_2012Metric; MPN CRCW080533R0FKEAC; LCSC Part # C126353
R535, R536, R537: 160; R_0805_2012Metric; MPN MCU08050C1600FPW00; LCSC Part # C246032
R540: *4; R_0805_2012Metric; MPN CRCW0805430RJNEA; LCSC Part # C137527
R541: *5; R_0805_2012Metric; MPN CRCW0805680RJNEA; LCSC Part # C93658
R545: 0; R_0805_2012Metric; MPN RCG08050000Z0EA; LCSC Part # C96345
R547: 100; R_0805_2012Metric; MPN CRCW0805100RJNEAHP; LCSC Part # C2078104
R559: 2K; R_0805_2012Metric; MPN CRCW08052K00JNEA; LCSC Part # C2077049
R560: 16K; R_0805_2012Metric; MPN TNPW080516K0BEEA; LCSC Part # C326942
R622: 1K; R_0805_2012Metric; MPN CRCW08051K00FKEA; LCSC Part # C136899
RA601, RA602, RA611, RA612: 4x10K; R_Array_Convex_4x0603; MPN YC164-FR-0710KL; LCSC Part # C110924
T520, T526, T527, T528, T547, T548, T555: TestPoint
T599: AS
TR501: NPN; SOT-23-3; MPN MMBT3904-TP; LCSC Part # C77991
TR502: NPN; SOT-23; MPN MMBT3904-TP; LCSC Part # C77991
X501: *3; Crystal_HC18-U_Vertical

Connections:
3BP_VIDEO_B: R528.1, T528.1
3BP_VIDEO_G: R527.1, T527.1
3BP_VIDEO_R: R526.1, T526.1
AVCC2: CE505.1, IC511.32 (VCC), R523.2
BFP: IC512.2 (BFP)
CTD0: RA602.3 (R3.1)
CTD1: RA612.4 (R4.1)
CTD2: RA612.3 (R3.1)
CTD3: RA601.3 (R3.1)
CTD4: RA601.2 (R2.1)
CTD5: RA612.2 (R2.1)
CTD6: RA612.1 (R1.1)
CTD7: RA602.2 (R2.1)
CTD8: RA602.4 (R4.1)
CTD9: RA602.1 (R1.1)
CTD10: RA601.1 (R1.1)
CTD11: RA601.4 (R4.1)
CTD12: RA611.4 (R4.1)
CTD13: RA611.3 (R3.1)
CTD14: RA611.2 (R2.1)
CTD15: RA611.1 (R1.1)
FTOB: R525.2
GND2: C592.1, C593.2, IC515.7 (GND), IC516.7 (GND), RA601.5 (R4.2), RA601.6 (R3.2), RA601.7 (R2.2), RA601.8 (R1.2), RA602.5 (R4.2), RA602.6 (R3.2), RA602.7 (R2.2), RA602.8 (R1.2), RA611.5 (R4.2), RA611.6 (R3.2), RA611.7 (R2.2), RA611.8 (R1.2), RA612.5 (R4.2), RA612.6 (R3.2), RA612.7 (R2.2), RA612.8 (R1.2)
GNDA2: C554.2, C555.2, C562.1, C563.1, C570.1, C573.1, C575.2, C578.2, C580.1, CE503.2, CE504.2, CE505.2, CE514.2, CE520.2, IC511.1 (GND), IC512.15 (GND), IC512.18 (GND), IC512.26 (GND), L604.2, R511.1, R512.1, R514.1, R516.1, R521.2, R522.2, R529.2, R530.2, R531.2, R535.2, R536.2, R537.2, R539.2, R622.1, TR501.2 (E)
IOB: R534.1
IOG: R533.1
IOR: R532.1
NTSC: IC512.32 (NTSC/PAL)
unnamed: C554.1, C588.1, R513.2, R514.2
unnamed: C555.1, C590.1, R515.2, R516.2
unnamed: C556.1, IC511.28 (MOUT2), R517.2
unnamed: C556.2, IC511.27 (LPIN2)
unnamed: C557.1, IC511.6 (MOUT1), R519.2
unnamed: C557.2, IC511.7 (LPIN1)
unnamed: C558.1, IC511.21 (LPF2)
unnamed: C558.2, C561.2, C563.2, CE504.1, IC511.9 (CDIN1), IC511.15 (REFO), IC511.19 (PSG), IC511.25 (CDIN2), R518.1, R520.1, T520.1
unnamed: C559.1, IC511.23 (LPO2)
unnamed: C559.2, IC511.22 (LFB2)
unnamed: C560.1, IC511.11 (LPO1)
unnamed: C560.2, IC511.12 (LFB1)
unnamed: C561.1, IC511.13 (LPF1)
unnamed: C562.2, D502.2 (A), IC511.18 (RESIN), R523.1, R524.2
unnamed: C564.1, R526.2, R529.1
unnamed: C564.2, IC512.4 (RIN1)
unnamed: C565.1, R527.2, R530.1
unnamed: C565.2, IC512.6 (GIN1)
unnamed: C566.1, R528.2, R531.1
unnamed: C566.2, IC512.8 (BIN1)
unnamed: C567.1, R532.2, R535.1
unnamed: C567.2, IC512.5 (RIN2)
unnamed: C568.1, R533.2, R536.1
unnamed: C568.2, IC512.7 (GIN2)
unnamed: C569.1, R534.2, R537.1
unnamed: C569.2, IC512.9 (BIN2)
unnamed: C570.2, C571.1, C572.2, R540.2
unnamed: C571.2, C572.1, X501.1
unnamed: C573.2, IC512.12 (YC), R541.2
unnamed: C574.1, L605.1, R545.2
unnamed: C574.2, C575.1, IC512.21 (YIN), L605.2
unnamed: C576.1, C576.2, IC512.17 (COUT), R547.1
unnamed: C577.1, IC512.19 (CIN)
unnamed: C577.2, C578.1, L604.1, R547.2
unnamed: C579.1, IC512.13 (PDO), R549.1, T548.1
unnamed: C579.2, C580.2, CE513.1, CE514.1, IC512.1 (VCC), IC512.25 (VCC), IC512.30 (VCC), L603.1, R621.2, T547.1, TR502.3 (C)
unnamed: C588.2, IC511.20 (FMIN2)
unnamed: C589.2, IC511.24 (ROMIN2)
unnamed: C590.2, IC511.14 (FMIN1)
unnamed: C591.2, IC511.10 (ROMIN1)
unnamed: C621.2, IC512.14 (VIN)
unnamed: CE503.1, IC511.16 (REFIN)
unnamed: CE506.1, IC511.31 (HPO2)
unnamed: CE507.1, IC511.2 (HPO1)
unnamed: CE512.1, R544.2
unnamed: CE513.2, R549.2
unnamed: IC511.3 (HPIN1), R519.1, R520.2
unnamed: IC511.30 (HPIN2), R517.1, R518.2
unnamed: IC512.10 (YA), TR502.1 (B)
unnamed: IC512.11 (YB), R541.1, X501.2
unnamed: IC512.20 (VOUT), R544.1
unnamed: IC512.22 (YOUT), R545.1
unnamed: IC512.31 (TEST), T555.1
unnamed: IC515.1 (~R), IC516.3, IC516.4, IC516.5
unnamed: IC515.6 (~Q), IC516.9
unnamed: IC516.1, IC516.2, R559.2, R560.1
unnamed: IC516.6, R560.2
unnamed: IC516.10, IC516.11
unnamed: R524.1, TR501.3 (C)
unnamed: R525.1, TR501.1 (B)
unnamed: R539.1, R540.1, TR502.2 (E)
PCM0: R515.1
PCM1: R513.1
SBCR: C621.1, R621.1, R622.2
SL1: C591.1, R512.2
SL4: CE507.2, R522.1
SR1: C589.1, R511.2
SR4: CE506.2, R521.1
VCC2: C592.2, C593.1, IC515.2 (D), IC515.4 (~S), IC515.10 (~S), IC515.11 (C), IC515.12 (D), IC515.13 (~R), IC515.14 (VCC), IC516.14 (VCC), L603.2, R558.1
XBOUT: IC512.27 (BOUT)
XGOUT: IC512.28 (GOUT)
XROUT: IC512.29 (ROUT)
XVOUT: CE512.2
~3BP_CSYNC: IC512.23 (CSYNC)
~AS: IC516.12, IC516.13, R558.2, R559.1, T599.1
~CAS0: IC515.3 (C)
~MRES: CE520.1, D502.1 (K)
~XAS: IC516.8
~XRESET: IC511.17 (RESO)
~YS0: IC512.3 (YS)

Notes on the sheet:
PAL
L604 L605 X501 R540 R541 C570 C574 C575 C578
NTSC
10uH 82uH 4.43361875MHz 430 680 68pF 15pF 47pF 82pF
1 2 3 4 5 8 9 10 11
12uH 100uH 3.579545MHz 560 1.2K 47pF 18pF 56pF 100pF
REF
Bridged, cut and place a cap if required
