jnnycn007/Neptune/misc.kicad_sch

## KiCad design misc.kicad_sch (2026-06-20)

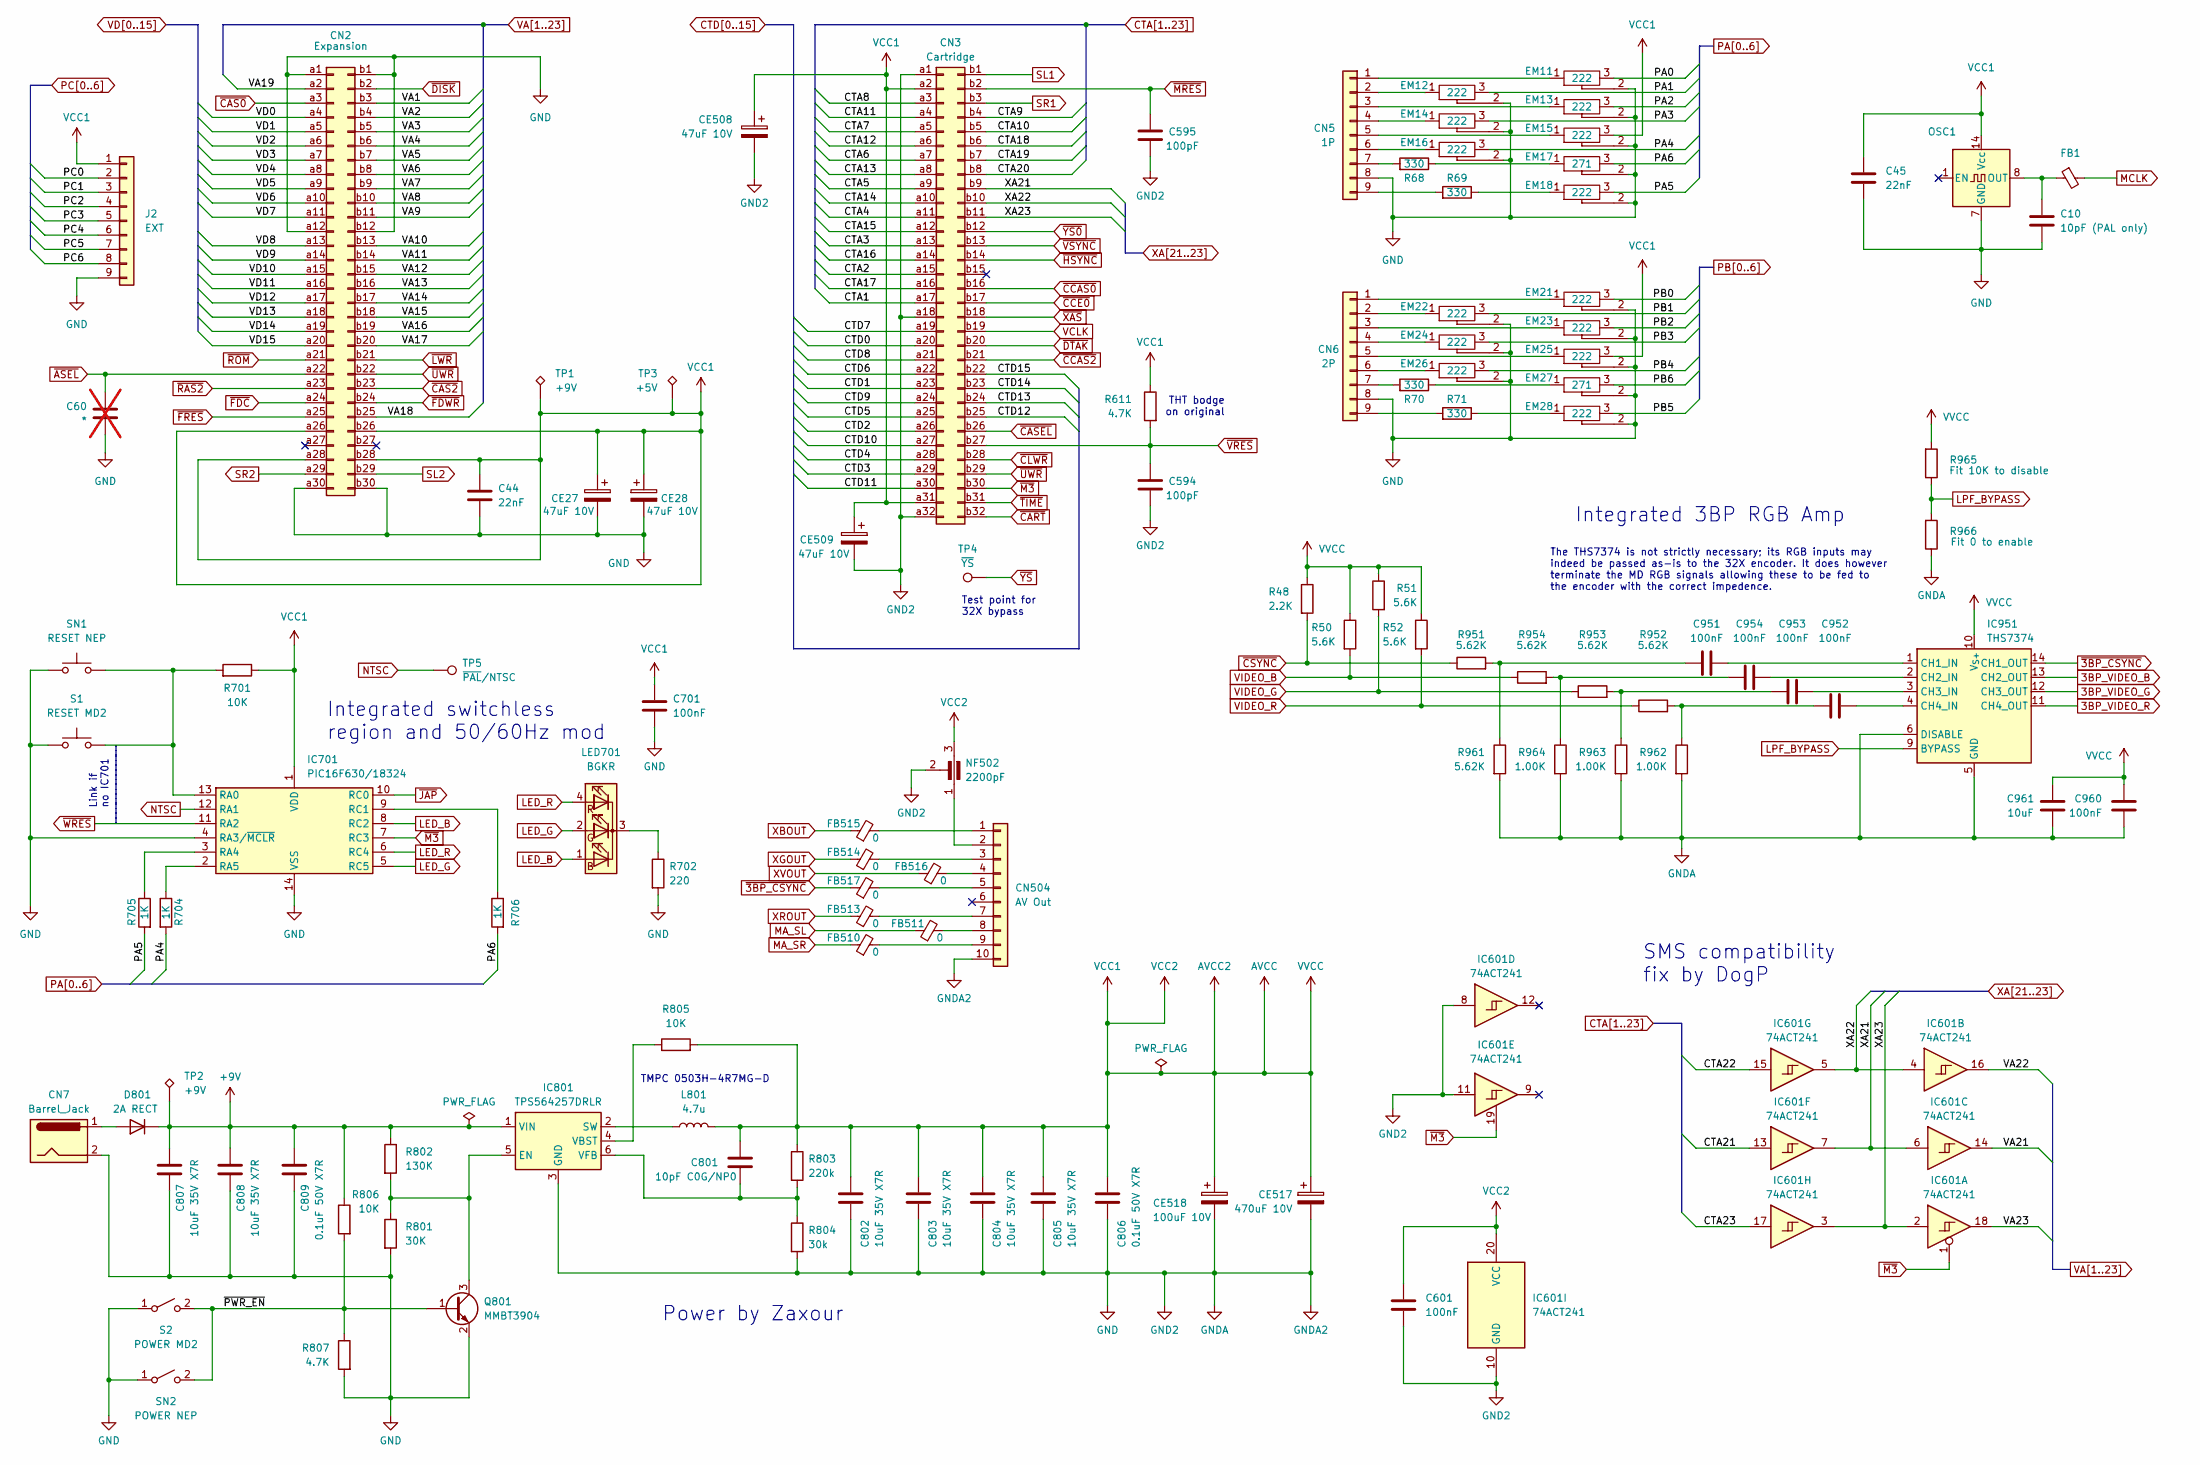
[picture p4: schematic misc.kicad_sch]

Parts:
C10: 10pF (PAL only); C_0805_2012Metric; MPN VJ0805A100FXJCW1BC; LCSC Part # C520053
C44, C45: 22nF; C_0805_2012Metric; MPN VJ0805Y223JXJPW1BC; LCSC Part # C520037
C60: *; C_0805_2012Metric; MPN VJ0805A151FXJCW1BC; LCSC Part # C107111; not fitted
C594, C595: 100pF; C_0805_2012Metric; MPN VJ0805A101FXJPW1BC; LCSC Part # C1854109
C601, C701, C951, C952, C953, C954, C960: 100nF; C_0805_2012Metric; MPN VJ0805Y104JXJMT; LCSC Part # C111492
C801: 10pF C0G/NP0; C_0805_2012Metric; MPN VJ0805D100FXAAP; DigiKey 311-4160-1-ND
C802, C803, C804, C805, C807, C808: 10uF 35V X7R; C_1206_3216Metric; MPN C3216X7R1V106KT000E; DigiKey 1276-3103-1-ND
C806: 0.1uF 50V X7R; C_0805_2012Metric; MPN VJ0805Y104JFAAR; LCSC Part # C111492
C809: 0.1uF 50V X7R; C_0805_2012Metric; MPN VJ0805Y104JFAAR; DigiKey 1276-1099-1-ND
C961: 10uF; C_0805_2012Metric; MPN CGA4J1X5R1C106KT0Y0E; DigiKey 1276-1096-1-ND
CE27, CE28, CE508: 47uF 10V; CP_Radial_D5.0mm_P2.50mm; DigiKey 493-13447-1-ND
CE509: 47uF 10V; CP_Radial_D5.0mm_P2.50mm_Horizontal; DigiKey 493-13447-1-ND
CE517: 470uF 10V; CP_Radial_D8.0mm_P5.00mm
CE518: 100uF 10V; CP_Radial_D5.0mm_P2.50mm
CN2: Expansion; Edge-60P
CN3: Cartridge; Cartidge_Slot
CN5: 1P; DSUB-9
CN6: 2P; DSUB-9
CN7: Barrel_Jack; Power_Jack
CN504: AV Out; AV_Connector
D801: 2A RECT; D_SOD-128; MPN CMS06(TE12L,Q,M); LCSC Part # C261920
EM11, EM12, EM13, EM14, EM15, EM16, EM18, EM21, EM22, EM23, EM24, EM25, EM26, EM28: 222; EMI_3P
EM17, EM27: 271; EMI_3P
FB1, FB510, FB511, FB513, FB514, FB515, FB516, FB517: 0; L_0805_2012Metric; MPN CBG201209U000T; LCSC Part # C91037
IC601: 74ACT241; TSSOP-20_4.4x6.5mm_P0.65mm; MPN SN74ACT241PW; DigiKey 296-4384-1-ND
IC701: PIC16F630/18324; DIP-14_W7.62mm_Socket
IC801: TPS564257DRLR; SOT-563; MPN TPS564257DRLR; DigiKey 296-TPS564257DRLRCT-ND
IC951: THS7374; TSSOP-14_4.4x5mm_P0.65mm; MPN THS7374IPWR; LCSC Part # C2652746
J2: EXT; EXT_Breakout
L801: 4.7u; L_Murata_LQH55DN_5.7x5.0mm; MPN LQH55DN4R7M03L; DigiKey 490-9760-1-ND
LED701: BGKR; RGB_LED
NF502: 2200pF; EMI_3P
OSC1: CXO_DIP14; Oscillator_DIP-8-14
Q801: MMBT3904; SOT-23; MPN MMBT3904-TP; DigiKey MMBT3904TPMSCT-ND
R48: 2.2K; R_0805_2012Metric; MPN CRCW08052K20JNEA; DigiKey P2.20KCCT-ND
R50, R51, R52: 5.6K; R_0805_2012Metric; MPN CRCW08055K60FKEA; LCSC Part # C844634
R68, R69, R70, R71: 330; R_0805_2012Metric; MPN CRCW0805330RFKEA; LCSC Part # C844839
R611: 4.7K; R_0805_2012Metric; MPN CRCW08054K70JNEAC; DigiKey P2.20KCCT-ND
R701: 10K; R_0805_2012Metric; MPN CRCW080510K0FKEA; DigiKey P220CCT-ND
R702: 220; R_0805_2012Metric; MPN CRCW0805220RFKEAC; DigiKey P220CCT-ND
R704, R705, R706: 1K; R_0805_2012Metric; MPN CRCW080510K0FKEA; DigiKey P220CCT-ND
R801: 30K; R_0805_2012Metric; MPN CRCW080530K0FKEA; DigiKey P30.0KCCT-ND
R802: 130K; R_0805_2012Metric; MPN RCS0805130KFKEA; DigiKey P162KCCT-ND
R803: 220k; R_0805_2012Metric; MPN CRCW0805220KJNEA; DigiKey P220KCCT-ND
R804: 30k; R_0805_2012Metric; MPN CRCW080530K0FKEA; DigiKey P30.0KCCT-ND
R805, R806: 10K; R_0805_2012Metric; MPN CRCW080510K0FKEA; LCSC Part # C844937
R807: 4.7K; R_0805_2012Metric; MPN CRCW08054K70JNEAC; LCSC Part # C2077067
R951, R952, R953, R954, R961: 5.62K; R_0805_2012Metric; MPN TNPW08055K62FHEA\; DigiKey P5.62KCCT-ND
R962, R963, R964: 1.00K; R_0805_2012Metric; MPN CRCW08051K00FKEA; DigiKey P1.00KCCT-ND
R965: Fit 10K to disable; R_0805_2012Metric; DigiKey P5.62KCCT-ND
R966: Fit 0 to enable; R_0805_2012Metric; DigiKey P5.62KCCT-ND
S1: RESET MD2; Reset_Switch
S2: POWER MD2; Power_Switch
SN1: RESET NEP; Reset_Switch
SN2: POWER NEP; Power_Switch
TP1, TP2: +9V; PinHeader_1x01_P2.54mm_Vertical
TP3: +5V; PinHeader_1x01_P2.54mm_Vertical
TP4: ~{YS}; TestPoint_Pad_D1.5mm
TP5: ~{PAL}/NTSC; TestPoint_Pad_D1.5mm

Connections:
3BP_VIDEO_B: IC951.13 (CH2_OUT)
3BP_VIDEO_G: IC951.12 (CH3_OUT)
3BP_VIDEO_R: IC951.11 (CH4_OUT)
+9V: C807.1, C808.1, C809.1, D801.1 (K), IC801.1 (VIN), R802.1, R806.1, TP2.1
AVCC: C44.1, C45.1, C601.1, C701.1, C801.1, C802.1, C803.1, C804.1, C805.1, C806.1, C960.1, C961.2, CE27.1, CE28.1, CE508.1, CE509.1, CE517.1, CE518.1, CN2.a26, CN2.a28, CN2.b26, CN2.b28, CN3.a2, CN3.a31, EM15.3, EM25.3, IC601.20 (VCC), IC701.1 (VDD), IC951.10 (V_{S+}), J2.1, L801.2, NF502.3, OSC1.14 (Vcc), R48.1, R50.1, R51.1, R52.1, R611.1, R701.1, R803.1, R805.2, R965.2, TP1.1, TP3.1
CTA1: CN3.a17
CTA2: CN3.a15
CTA3: CN3.a13
CTA4: CN3.a11
CTA5: CN3.a9
CTA6: CN3.a7
CTA7: CN3.a5
CTA8: CN3.a3
CTA9: CN3.b4
CTA10: CN3.b5
CTA11: CN3.a4
CTA12: CN3.a6
CTA13: CN3.a8
CTA14: CN3.a10
CTA15: CN3.a12
CTA16: CN3.a14
CTA17: CN3.a16
CTA18: CN3.b6
CTA19: CN3.b7
CTA20: CN3.b8
CTA21: IC601.13
CTA22: IC601.15
CTA23: IC601.17
CTD0: CN3.a20
CTD1: CN3.a23
CTD2: CN3.a26
CTD3: CN3.a29
CTD4: CN3.a28
CTD5: CN3.a25
CTD6: CN3.a22
CTD7: CN3.a19
CTD8: CN3.a21
CTD9: CN3.a24
CTD10: CN3.a27
CTD11: CN3.a30
CTD12: CN3.b25
CTD13: CN3.b24
CTD14: CN3.b23
CTD15: CN3.b22
GND: C10.2, C44.2, C45.2, C60.2, C594.1, C595.1, C601.2, C701.2, C802.2, C803.2, C804.2, C805.2, C806.2, C807.2, C808.2, C809.2, C960.2, C961.1, CE27.2, CE28.2, CE508.2, CE509.2, CE517.2, CE518.2, CN2.a1, CN2.a12, CN2.a30, CN2.b1, CN2.b12, CN2.b30, CN3.a1, CN3.a18, CN3.a32, CN5.8, CN6.8, CN7.2, CN504.10, EM11.2, EM12.2, EM13.2, EM14.2, EM15.2, EM16.2, EM17.2, EM18.2, EM21.2, EM22.2, EM23.2, EM24.2, EM25.2, EM26.2, EM27.2, EM28.2, IC601.8, IC601.10 (GND), IC601.11, IC701.4 (RA3/~MCLR), IC701.14 (VSS), IC801.3 (GND), IC951.5 (GND), IC951.6 (DISABLE), J2.9, NF502.2, OSC1.7 (GND), Q801.2 (E), R702.2, R801.2, R804.2, R807.2, R961.2, R962.2, R963.2, R964.2, R966.1, S1.1, S2.1 (A), SN1.1, SN2.1 (A)
LED_B: IC701.8 (RC2), LED701.1 (BA)
LED_G: IC701.5 (RC5), LED701.2 (GA)
LED_R: IC701.6 (RC4), LED701.4 (RA)
LPF_BYPASS: IC951.9 (BYPASS), R965.1, R966.2
MA_SL: FB511.1
MA_SR: FB510.1
MCLK: FB1.2
NTSC: IC701.12 (RA1), TP5.1
unnamed: C10.1, FB1.1, OSC1.8 (OUT)
unnamed: C801.2, IC801.6 (VFB), R803.2, R804.1
unnamed: C951.1, R951.2, R961.1
unnamed: C951.2, IC951.1 (CH1_IN)
unnamed: C952.1, R952.2, R962.1
unnamed: C952.2, IC951.4 (CH4_IN)
unnamed: C953.1, R953.2, R963.1
unnamed: C953.2, IC951.3 (CH3_IN)
unnamed: C954.1, R954.2, R964.1
unnamed: C954.2, IC951.2 (CH2_IN)
unnamed: CN5.1, EM11.1
unnamed: CN5.2, EM12.1
unnamed: CN5.3, EM13.1
unnamed: CN5.4, EM14.1
unnamed: CN5.5, EM15.1
unnamed: CN5.6, EM16.1
unnamed: CN5.7, R68.2
unnamed: CN5.9, R69.2
unnamed: CN6.1, EM21.1
unnamed: CN6.2, EM22.1
unnamed: CN6.3, EM23.1
unnamed: CN6.4, EM24.1
unnamed: CN6.5, EM25.1
unnamed: CN6.6, EM26.1
unnamed: CN6.7, R70.2
unnamed: CN6.9, R71.2
unnamed: CN7.1, D801.2 (A)
unnamed: CN504.1, FB515.2
unnamed: CN504.2, NF502.1
unnamed: CN504.3, FB514.2
unnamed: CN504.4, FB516.2
unnamed: CN504.5, FB517.2
unnamed: CN504.7, FB513.2
unnamed: CN504.8, FB511.2
unnamed: CN504.9, FB510.2
unnamed: EM17.1, R68.1
unnamed: EM18.1, R69.1
unnamed: EM27.1, R70.1
unnamed: EM28.1, R71.1
unnamed: IC701.2 (RA5), R704.1
unnamed: IC701.3 (RA4), R705.1
unnamed: IC701.9 (RC1), R706.1
unnamed: IC701.13 (RA0), R701.2, S1.2, SN1.2
unnamed: IC801.2 (SW), L801.1
unnamed: IC801.4 (VBST), R805.1
unnamed: IC801.5 (EN), Q801.3 (C), R801.1, R802.2
unnamed: LED701.3 (K), R702.1
PA0: EM11.3
PA1: EM12.3
PA2: EM13.3
PA3: EM14.3
PA4: EM16.3, R704.2
PA5: EM18.3, R705.2
PA6: EM17.3, R706.2
PB0: EM21.3
PB1: EM22.3
PB2: EM23.3
PB3: EM24.3
PB4: EM26.3
PB5: EM28.3
PB6: EM27.3
PC0: J2.2
PC1: J2.3
PC2: J2.4
PC3: J2.5
PC4: J2.6
PC5: J2.7
PC6: J2.8
SL1: CN3.b1
SL2: CN2.b29
SR1: CN3.b3
SR2: CN2.a29
VA1: CN2.b3
VA2: CN2.b4
VA3: CN2.b5
VA4: CN2.b6
VA5: CN2.b7
VA6: CN2.b8
VA7: CN2.b9
VA8: CN2.b10
VA9: CN2.b11
VA10: CN2.b13
VA11: CN2.b14
VA12: CN2.b15
VA13: CN2.b16
VA14: CN2.b17
VA15: CN2.b18
VA16: CN2.b19
VA17: CN2.b20
VA18: CN2.b25
VA19: CN2.a2
VA21: IC601.14
VA22: IC601.16
VA23: IC601.18
VCLK: CN3.b19
VD0: CN2.a4
VD1: CN2.a5
VD2: CN2.a6
VD3: CN2.a7
VD4: CN2.a8
VD5: CN2.a9
VD6: CN2.a10
VD7: CN2.a11
VD8: CN2.a13
VD9: CN2.a14
VD10: CN2.a15
VD11: CN2.a16
VD12: CN2.a17
VD13: CN2.a18
VD14: CN2.a19
VD15: CN2.a20
VIDEO_B: R50.2, R954.1
VIDEO_G: R51.2, R953.1
VIDEO_R: R52.2, R952.1
XA21: CN3.b9, IC601.6, IC601.7
XA22: CN3.b10, IC601.4, IC601.5
XA23: CN3.b11, IC601.2, IC601.3
XBOUT: FB515.1
XGOUT: FB514.1
XROUT: FB513.1
XVOUT: FB516.1
~3BP_CSYNC: FB517.1, IC951.14 (CH1_OUT)
~ASEL: C60.1, CN2.a22
~CART: CN3.b32
~CAS0: CN2.a3
~CAS2: CN2.b23
~CASEL: CN3.b26
~CCAS0: CN3.b16
~CCAS2: CN3.b21
~CCE0: CN3.b17
~CLWR: CN3.b28
~CSYNC: R48.2, R951.1
~DISK: CN2.b2
~DTAK: CN3.b20
~FDC: CN2.a24
~FDWR: CN2.b24
~FRES: CN2.a25
~HSYNC: CN3.b14
~JAP: IC701.10 (RC0)
~LWR: CN2.b21
~M3: CN3.b30, IC601.1, IC601.19, IC701.7 (RC3)
~MRES: C595.2, CN3.b2
~PWR_EN: Q801.1 (B), R806.2, R807.1, S2.2 (B), SN2.2 (B)
~RAS2: CN2.a23
~ROM: CN2.a21
~TIME: CN3.b31
~UWR: CN2.b22, CN3.b29
~VRES: C594.2, CN3.b27, R611.2
~VSYNC: CN3.b13
~WRES: IC701.11 (RA2)
~XAS: CN3.b18
~YS0: CN3.b12
~YS: TP4.1

Notes on the sheet:
TMPC 0503H-4R7MG-D
Power by Zaxour
THT bodge on original
Test point for 32X bypass
SMS compatibility fix by DogP
Link if no IC701
Integrated switchless region and 50/60Hz mod
Integrated 3BP RGB Amp
The THS7374 is not strictly necessary; its RGB inputs may indeed be passed as-is to the 32X encoder. It does however terminate the MD RGB signals allowing these to be fed to the encoder with the correct impedence.
