jnnycn007/Neptune/(commit log)

2026-01-30 Silkscreen updates.
    [misc.kicad_sch]
2026-05-18 Rename CE502 -> CE602 and use original 32X value (issue #19).
    [32X_main1.kicad_sch]
2026-05-18 Rename OIR -> IOR (issue #20).
    [32X_main2.kicad_sch, 32X_sub.kicad_sch]
2026-05-27 Add resistors for IGR, including PA6/SELECT line.
    [misc.kicad_sch]
2026-06-20 Route /M3 to PIC in case useful for IGR or other functionality. Remove solder mask around edge connector fingers.
    [misc.kicad_sch]
